NSA201006/Piezoelectric-Energy-Harvester/Report.pdf

# Electronics Workshop II, Project-2 Piezoelectric Energy Harvester Table 5, Nilgiri 104

Nagamalla Sai Abhinav
2024102037
Electronics and Communication Engineering IIIT Hyderabad
saiabhinav.nagamalla@students.iiit.ac.in

Praveen V
2024102019
Electronics and Communication Engineering IIIT Hyderabad
praveen.v@students.iiit.ac.in

Abstract—The project statement is to create a piezoelectric energy harvesting circuit with AC-DC conversion and voltage regulation to power a low-power sensor nodes from vibrations or footsteps. The piezoelectric energy harvesting technique is based on the materials property of generating an electric field when a mechanical force is applied. This phenomenon is known as the direct piezoelectric effect. AC-DC conversion is done by a full-wave rectifier while the voltage regulation is done with the help of a buck converter.

Index Terms—Piezoelectric materials, Buck converter, AC-DC regulator, Low Power devices.

I. INTRODUCTION

In recent decades, advancements in wireless technology and microelectronics have enabled the development of wearable devices, including clothing and accessories, powered by batteries or energy harvesting systems. Alongside this, the concept of the Internet of Things (IoT) has emerged, where wireless sensor networks are widely used. IoT has made it possible to deploy smart devices in remote or hard-to-reach locations, such as medical implants inside the human body and infrastructure within smart buildings, where recharging or replacing batteries is challenging.

Although low power integrated circuit technology has improved significantly, the energy density of conventional batteries still falls short of meeting the demands of these applications. As a result, there is a growing need for alternative energy harvesting methods to support self powered systems. Beyond being a practical and cost effective substitute for batteries, energy harvesting also contributes to reducing greenhouse gas emissions and promoting environmental sustainability.

Energy harvesting can be carried out by converting various forms of ambient energy available in the environment, as well as energy generated by humans in their daily activities.

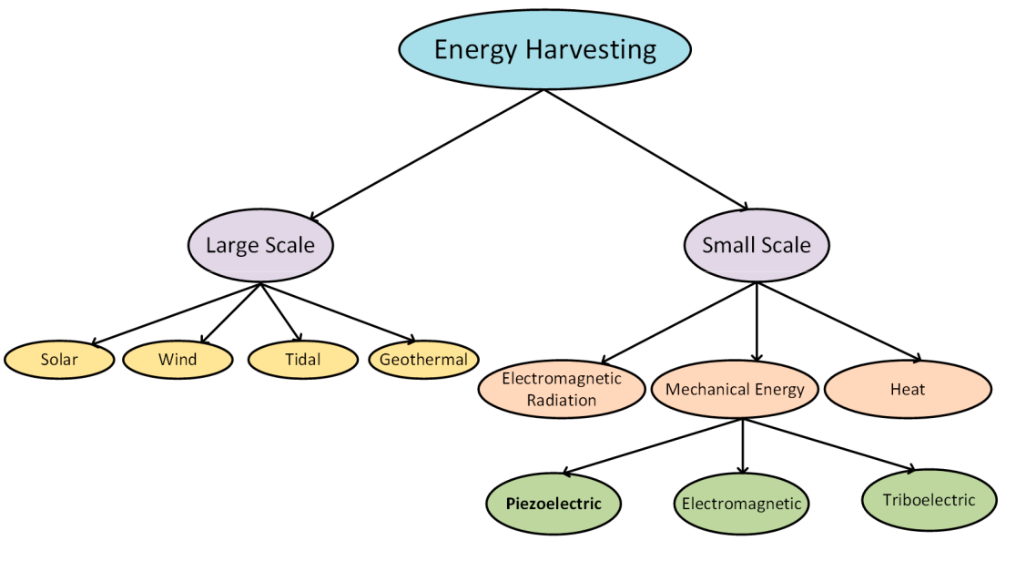
[picture p1: figure]

Fig. 1: Classification of energy harvesting sources

Human body mechanical energy and environmental mechanical energy are widely utilized due to their abundance in everyday life. Any motion in nature can serve as a potential source of kinetic energy. As a result, mechanical energy is one of the most commonly available forms of energy. By harvesting mechanical energy, sufficient power can be generated to support long-term operation of self-powered systems. For instance, approximately 10 mW can be harvested from upper limb movements, about 1 mW from typing activity, nearly 100 µW from breathing, and up to 1 W can be generated while walking.
We generate up to 1W. The harvested power density Pres for mechanical energy depends on the motion frequency and magnitude, as shown in the resonance power formula:

Pres = 4π

3mf ³
resyZmax | (1)

where m is the inertial mass, Zmax is the maximum displacement, fres is the resonance frequency, and y is the amplitude of vibration of the housing.

Fig. 2: Frequency level for different mechanical energy sources

II. PIEZO ARRAY

A. Piezoelectric Functionality

The piezoelectric sensor used in this project is typically made of lead zirconate titanate (PZT), which provides higher efficiency compared to natural materials like quartz.

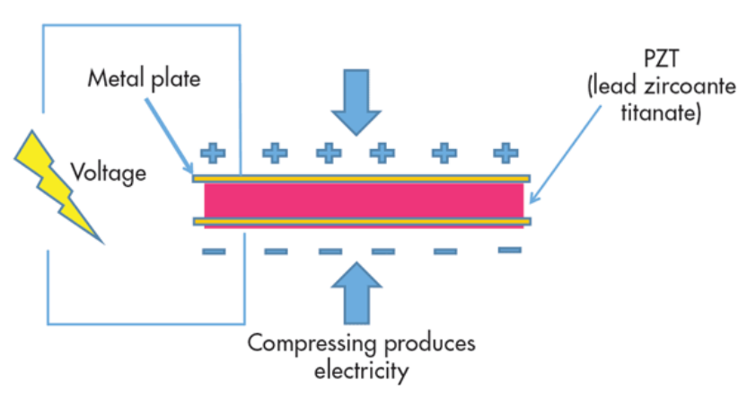
[picture p2: figure]

Fig. 3: Working of a piezoelectric sensor

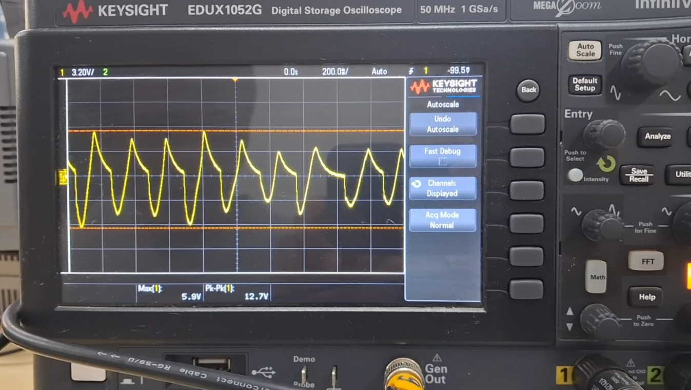
[picture p3: figure]

Fig. 4: Output obtained by tapping a single piezo

Piezoelectricity translates to “electricity from pressure.” The prefix piezo in Greek means to press or squeeze. Piezoelectric materials exhibit the piezoelectric effect. This allows a mechanical force to be applied to the material to deform it slightly and the material will produce an output electric power. This is done by rearranging the dipoles of the piezoelectric material. This rearrangement causes a change in the dipole density and therefore a change in the electric field between the dipoles. Because of this change in the electric field, the piezoelectric material produces an output electric power.

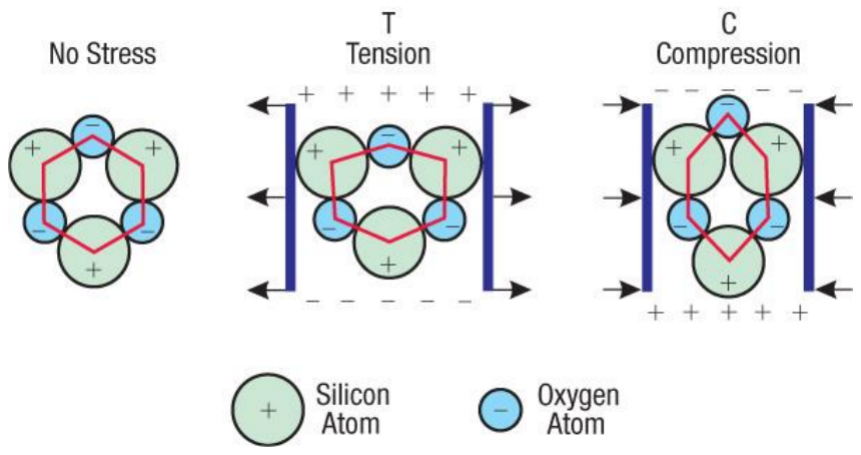
[picture p4: figure]

Fig. 5: The piezoelectric effect as observed in Quartz(SiO2)

B. Piezoelectric Sensor Array Configuration

In order to increase the output voltage and power, multiple piezoelectric sensors were connected in a combination of series and parallel configurations. A total of 20 piezoelectric sensors were used.
Four piezoelectric sensors were connected in series to form a single group. Connecting sensors in series increases the output voltage, as the voltages of individual sensors add up. Five such series groups were then connected in parallel. Parallel connection helps in increasing the output current while maintaining the voltage level.
Thus, the overall configuration consists of 5 parallel branches, each containing 4 piezoelectric sensors in series. This combination ensures that both voltage and current are improved, making the output more suitable for practical applications such as energy harvesting and powering low-power electronic circuits.
The output of a single piezoelectric sensor is typically very low and unstable. Hence, combining multiple sensors helps in improving the overall efficiency and usability of the generated electrical energy.

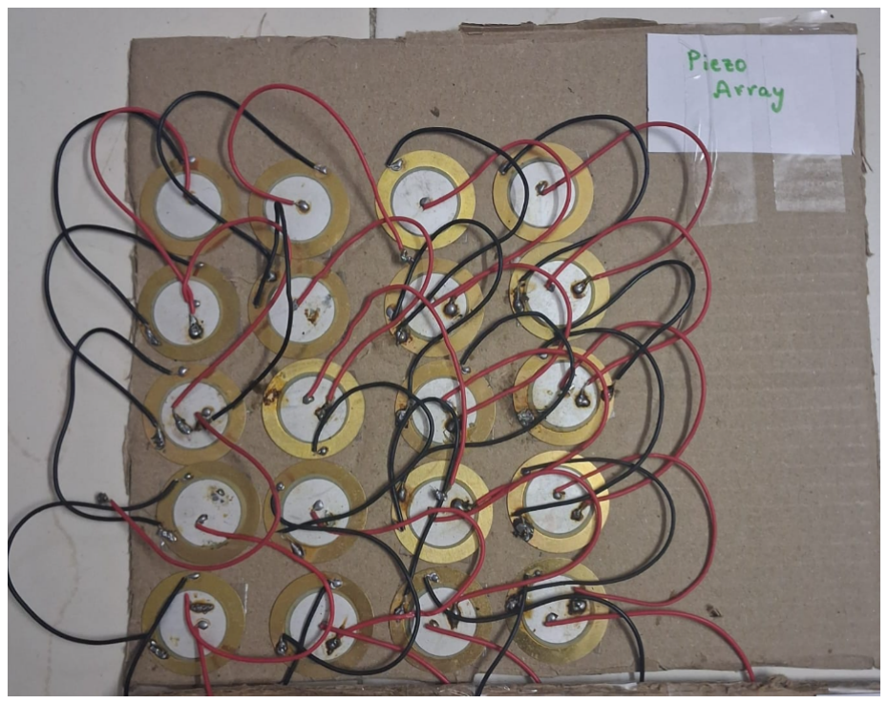
[picture p5: figure]

Fig. 6: Piezoelectric sensor setup

C. Demonstration videos

The working of the piezoelectric energy harvesting system is demonstrated through the video titled piezo output.mp4, which can be accessed here. (https://drive.google.com/drive/folders/1y0cQnUVNwf2e0C1tP7GsdZZJ_Ef59SJM?usp=drive_link)

III. AC-DC CONVERTER

A. Theory of AC-DC converter

The voltage generated by the piezoelectric array is inherently alternating (AC) in nature. To make it suitable for practical applications—especially for powering DC loads—we incorporate an AC–DC conversion stage. This is achieved through rectification using diodes, which allow current to flow only in one direction.
Instead of a half-wave rectifier, we employ a full-wave rectifier. Unlike the half-wave configuration—which utilizes only one half-cycle of the input signal—a full-wave rectifier converts both the positive and negative halves of the AC waveform into a unidirectional output. As a result, it delivers a higher average output voltage, improved power efficiency, and significantly reduced ripple. This makes it more suitable for energy harvesting applications like piezoelectric systems, where maximizing the usable output from a low and variable input is critical.
The resulting output is a pulsating DC signal, which can be further smoothed using filtering components such as capacitors if required.
If we need to rectify AC power to obtain the full use of both half-cycles of the sine wave, a full wave rectifier must be used.

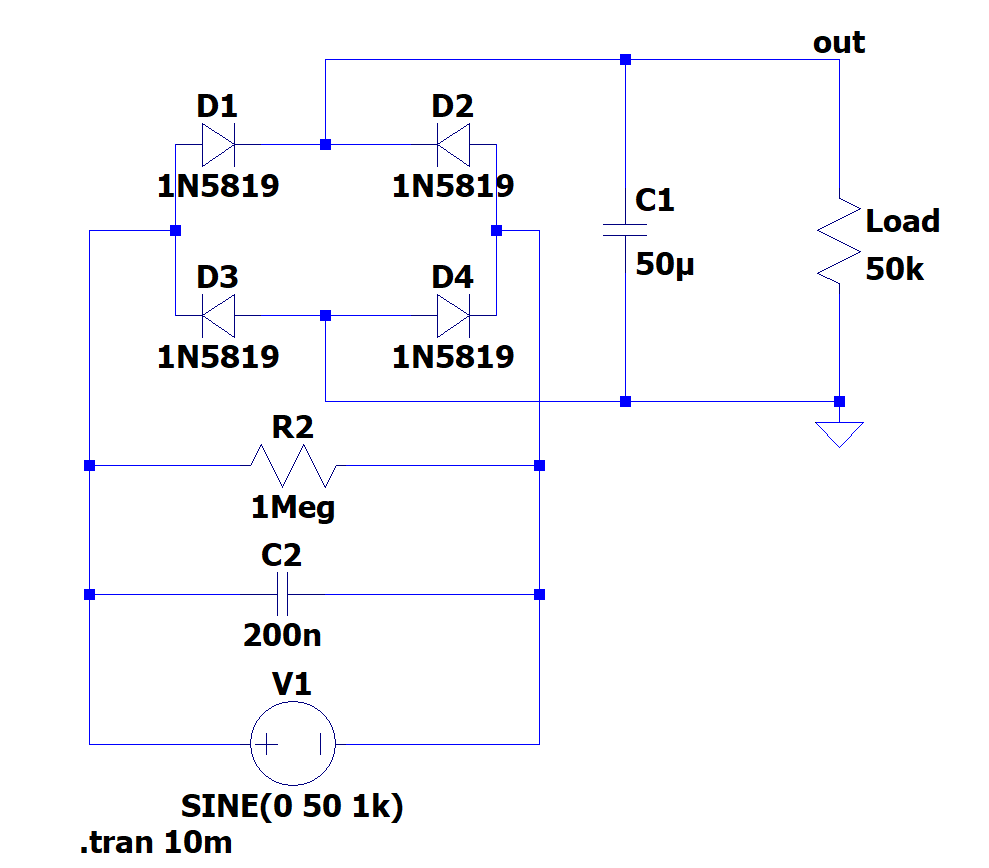
[picture p6: figure]

Fig. 7: LTSpice circuit of a full wave rectifier (Resistor and capacitor model the piezo array impedances)

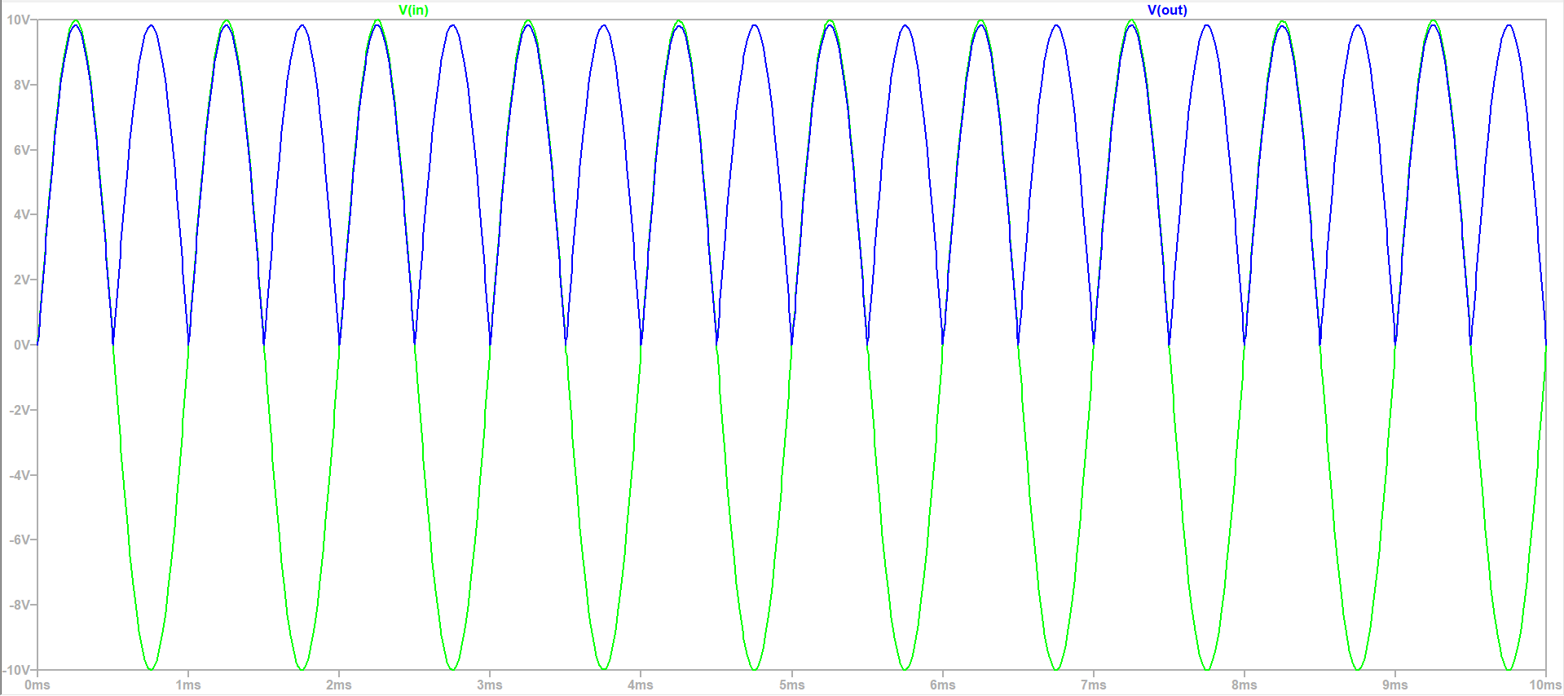
[picture p7: figure]

Fig. 8: LTspice simulation output for full-wave rectifier

The current flow is through two diodes in series for both polarities. Thus, two diode drops of the source voltage are lost (0.7 · 2 = 1.4 V for Si) in the diodes. This is a disadvantage which is dealt by using a schottky diode which has a much lower forward voltage drop of 0.2 V to 0.3 V. Therefore the voltage lost comes down to 0.4 V (0.2 · 2) to 0.6 V (0.3 · 2) which is significantly better than a normal silicon diode.

Current directions for the full-wave bridge rectifier circuit are as shown in the figure below for positive half-cycle and the figure below for negative half-cycles of the AC source waveform. Note that regardless of the polarity of the input, the current flows in the same direction through the load. That is, the negative half-cycle of source is a positive half-cycle at the load.

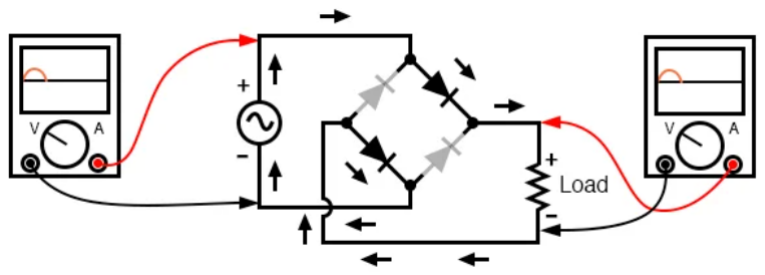
[picture p8: figure]

Fig. 9: Full-wave bridge rectifier: Current flow for positive half-cycles

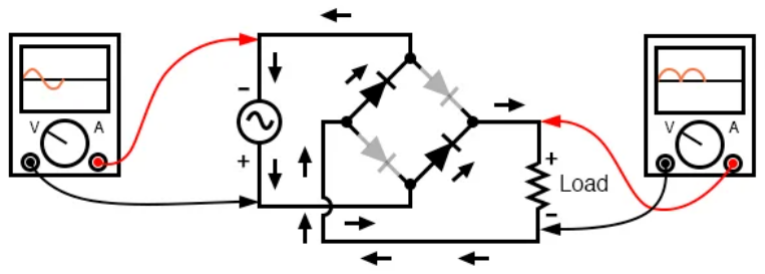
[picture p9: figure]

Fig. 10: Full-wave bridge rectifier: Current flow for negative half-cycles

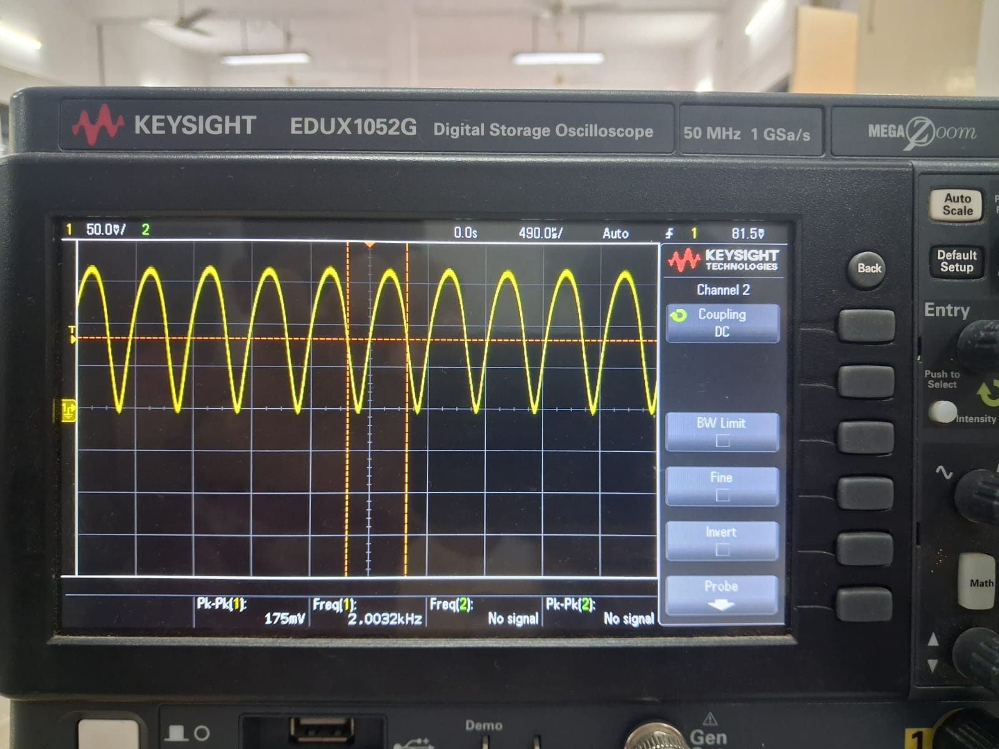
[picture p10: figure]

Fig. 11: Full Wave rectification of a sine wave

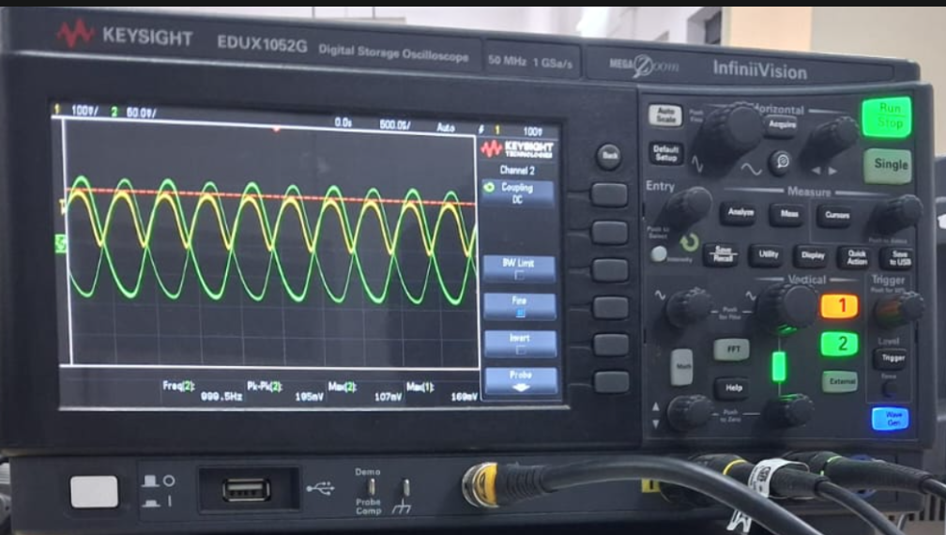
[picture p11: figure]

Fig. 12: Full Wave rectification plotted against input

A filter capacitor at the rectifier output smooths the pulsating DC by charging to the peak voltage and discharging slowly between cycles, effectively performing envelope detection to yield a steady DC level.

B. Obtained results

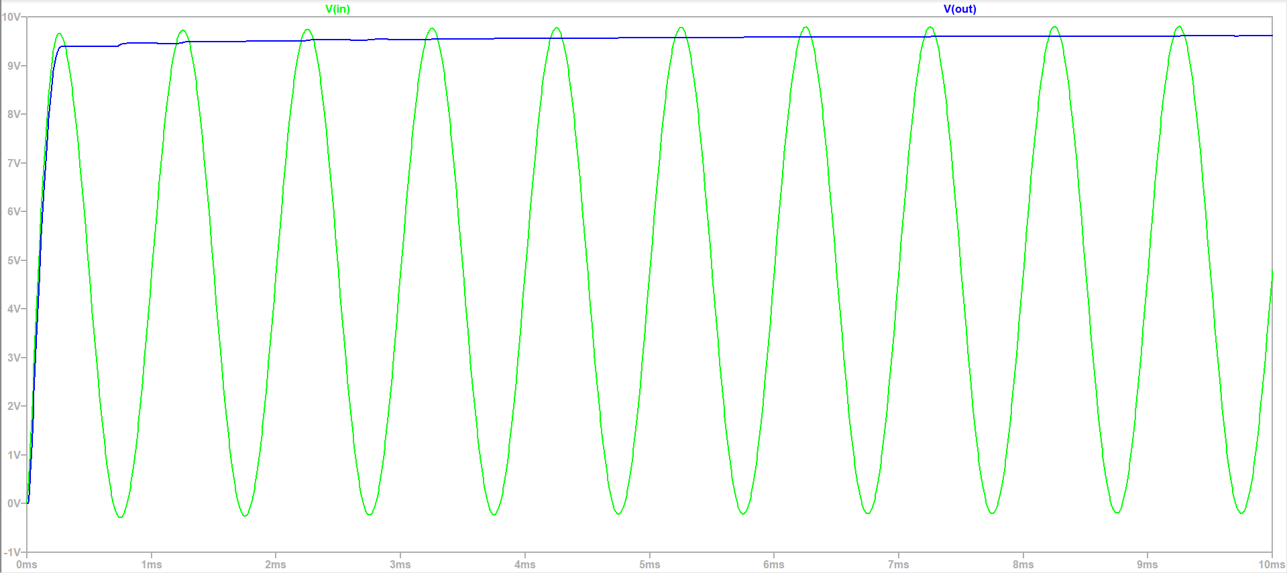
[picture p12: figure]

Fig. 13: Full-wave rectified output with filtering in LTspice

From the above simulation result, we can see for 10V AC Amplitude, output is around 9.6V DC. There is only 0.4V drop in the voltage due to 2 Schottky diodes used in series.

C. Demonstration videos

The working of the AC-DC converter is demonstrated through the videos titled piezo output after AC to DC.mp4 and piezo output of one series block after AC to DC.mp4, which can be accessed here. (https://drive.google.com/drive/folders/1y0cQnUVNwf2e0C1tP7GsdZZJ_Ef59SJM?usp=drive_link)

IV. BUFFER

In piezoelectric energy harvesting systems, the source typically exhibits a high output impedance and limited current capability. Directly connecting such a source to a load such as a buck converter will lead to significant loading effects. The switching action of the buck converter draws pulsed current, which can collapse the piezoelectric output voltage, reduce the effective harvested energy, and degrade overall system performance. Therefore, impedance matching is critical.

To address this issue, a buffer stage is introduced between the rectifier output and the buck converter. The buffer is implemented using an LM358 operational amplifier configured as a unity-gain voltage follower. In this configuration, the output is directly fed back to the inverting terminal, while the input is applied to the non-inverting terminal, ensuring that the output voltage closely follows the input voltage.

The key advantage of this configuration lies in its impedance characteristics. The op-amp presents a very high input impedance to the piezoelectric source, thereby minimizing the loading effect and allowing maximum voltage to be extracted. At the same time, it provides a low output impedance to drive the buck converter effectively, ensuring stable operation even under dynamic load conditions. Thus, the buffer stage acts as an isolation interface between the high-impedance energy source and the low-impedance switching load.

The LM358 buffer is powered directly from the piezo rectifier output, not from any external supply. Since the LM358 supports single-supply operation down to approximately 3 V, and the rectified output typically reaches 5–10 V during mechanical excitation, the op-amp is able to self-power from the harvested energy itself. This ensures that the buffer stage remains fully consistent with the self-powered design objective of the system. The LM358 buffer working range of voltage is 3 to 32 V which falls in piezo rectifier output voltage range.

Overall, the buffer stage significantly improves energy transfer efficiency and system stability by decoupling the piezo rectifier stage and the buck controller stage

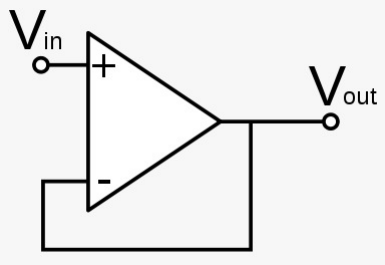
[picture p13: figure]

Fig. 14: Circuit Diagram of the Buffer used

V. BUCK CONVERTER

The voltage obtained after rectification is a varying DC voltage. A DC–DC buck converter steps this down to the required constant 3.3 V output using a high-frequency switching power MOSFET (IRLZ44N) controlled by a PWM signal from an Arduino microcontroller.

A. Why Not a Linear Voltage Regulator?

A linear voltage regulator such as the LM7805 could theoretically step down the rectified voltage to a fixed output, but it is highly unsuitable for this application for the following reasons.
- Output voltage regulated by adjusting the transistor base current
- Power absorbed by the load Po = VoIo
- Power dissipated by the transistor PT = VCEIo
- Inefficient due to high power dissipation by the transistor.
- Requires a minimum headroom voltage Vheadroom = Vin− Vout to maintain regulation; for our design Vheadroom = 10 − 3.3 = 6.7 V, meaning the transistor must withstand and waste an enormous voltage drop, making it completely impractical
To tackle this problem, we model the buck converter as a switching voltage regulator, as explained below.
B. Theory of switching voltage regulator

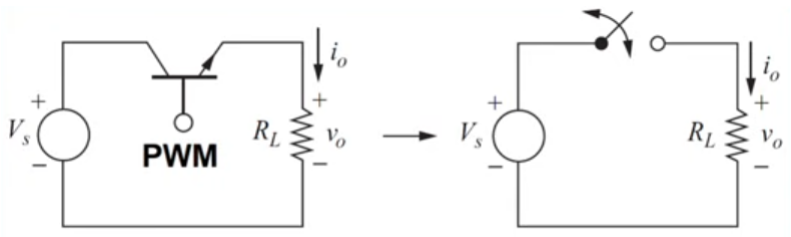
[picture p14: figure]

Fig. 15: Buck converter modelled as a switching voltage regulator

The buck converter consists of an N-MOSFET switch, inductor L, capacitor C, freewheeling diode D1, and load R. The PWM duty cycle is defined as:

D =

ton
T

=

ton
ton + toff

(2)

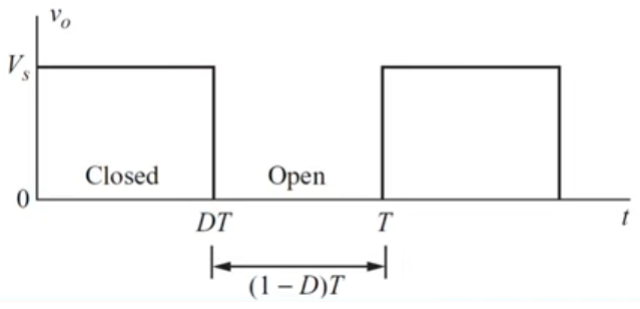
[picture p15: figure]

Fig. 16: Duty cycle of a switching voltage regulator

- Gate voltage = 0: switch open ⇒ Vout = 0
- Gate voltage = high: switch closed ⇒ Vout = Vin
- Switch closed: diode D1 is reverse biased
- Switch open: diode D1 forward biased; inductor current freewheels through D1
C. Derivations and Calculations for Buck converter

It is important to note that the buck converter is designed for a fixed input of Vin = 10 V, representing the nominal rectified output under steady mechanical excitation. Under this assumption, a fixed duty cycle of D = 0.33 is sufficient to regulate the output to 3.3 V. However, in practice, the piezoelectric source is inherently variable the rectified voltage fluctuates depending on the amplitude and frequency of mechanical input. To account for this, a feedback based bang-bang controller (discussed in next Section) is introduced, which dynamically adjusts the duty cycle in real time to maintain a stable 3.3 V output across varying input conditions. Output Voltage: The average output voltage is obtained by integrating over one switching period:

Vout =

1
T

Z T

0

Vout(t) dt

=

1
T

"Z DT

0

Vin dt +

Z T

DT

0 dt#

=

Vin · DT
T

(3)

Vout = D · Vin | (4)

The required duty cycle is therefore:

D =

Vout
Vin

=

3.3
10
= 0.33 | (5)

Steady-State Inductor Ripple: Since the gate signal is periodic, iL(t + T) = iL(t). Volt-second balance requires the average inductor voltage to be zero:

VL,avg =

1
T

Z t+T

t

VL(τ ) dτ = 0 | (6)

Switch closed (0 ≤ t ≤ DT):

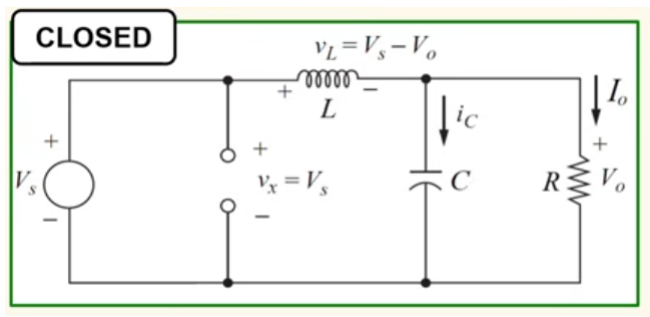
[picture p16: figure]

Fig. 17: Buck converter circuit during switch ON (closed) condition

VL = VS − Vo = L

diL
dt | (7)

∆iL,closed =

(VS − Vo) DT
L

(8)

Switch open (DT ≤ t ≤ T):

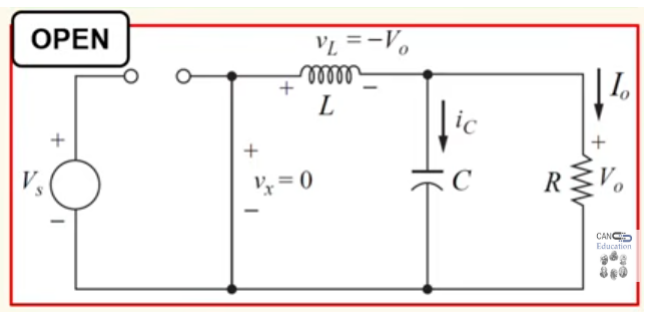
[picture p17: figure]

Fig. 18: Buck converter circuit during switch OFF (open) condition

VL = −Vo = L

diL
dt | (9)

∆iL,open =

−Vo (1 − D) T
L

(10)

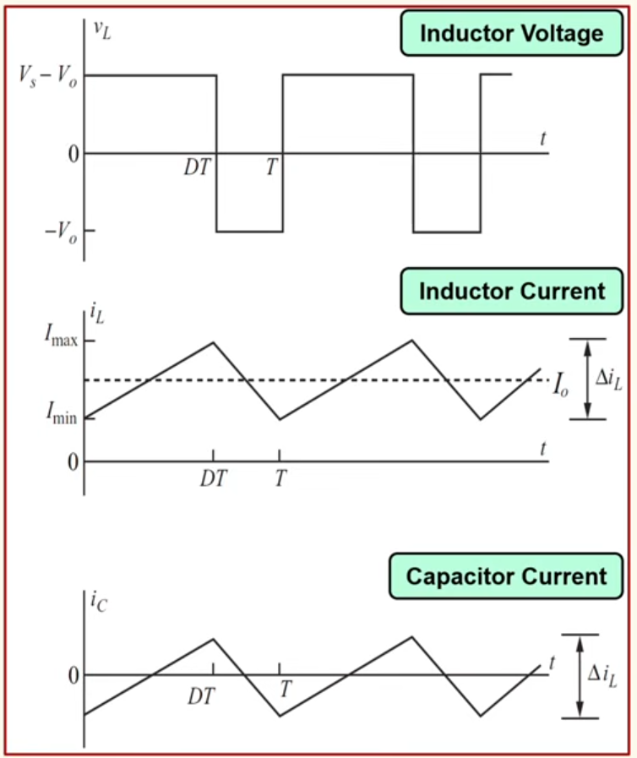
[picture p18: figure]

Fig. 19: Buck converter waveforms

Applying the steady-state condition ∆iL,closed + ∆iL,open = 0 confirms Vo = DVS. The peak-to-peak inductor current ripple is:

∆iL =

Vo(1 − D)
L fs

(11)

Inductor Design: At steady state IL = Io = Vo/R, giving peak and minimum currents:

Imax =

Vo
R

+

Vo(1 − D)
2Lfs

(12)

Imin =

Vo
R

−

Vo(1 − D)
2Lfs

(13)

For Continuous Conduction Mode (CCM), Imin > 0, which gives:

Lmin =

(1 − D) R
2 fs

(14)

Taking ∆iL = 5% of Io = 1 A = 50mA and fs = 50 kHz:

L =

Vo(1 − D)
∆iL · fs

=

3.3 × 0.67
0.05 × 50 × 10³

≈ 884.4 µH (15)

We select L = 890 µH (four 220 µH + one 10 µH inductors in series). The revised ripple becomes:

∆iL,new =

Vo(1 − D)
L fs

=

3.3 × 0.67
890 × 10⁻⁶ × 50 × 10³

≈ 49.6 mA

(16)

The Arduino can provide PWM at up to 62.5 kHz, so fs = 50 kHz is well within range. The inductor RMS current is:

IL(rms) =

s
I

2
L +
∆iL/2
√
3

2
≈ 2.0001 A (17)

Capacitor Design: The charge variation equals the area under the iC vs. t graph:

∆Q =

∆iL
8 fs

(18)

Output Voltage Ripple

Capacitor current: iC = iL − io | (19)
Capacitor charge: Q = CVo | (20)

Change in capacitor charge:

∆Q = C∆Vo | (21)

∆Q =

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
∆iL T
8

=

∆iL
8fs

(22)

Change in output voltage:

∆Vo =

∆Q
C

=

∆iL
8Cfs

(23)

∆iL =

Vo(1 − D)
Lfs

(24)

∆Vo =

1
8Cfs

·

Vo(1 − D)
Lfs

(25)

=

Vo(1 − D)
8LCf ²
s

(26)

Rearranging with ∆Vo/Vo = 1% (target):

C =

1 − D

8L

∆Vo
Vo
f

2
s
≈ 3.76 µF | (27)

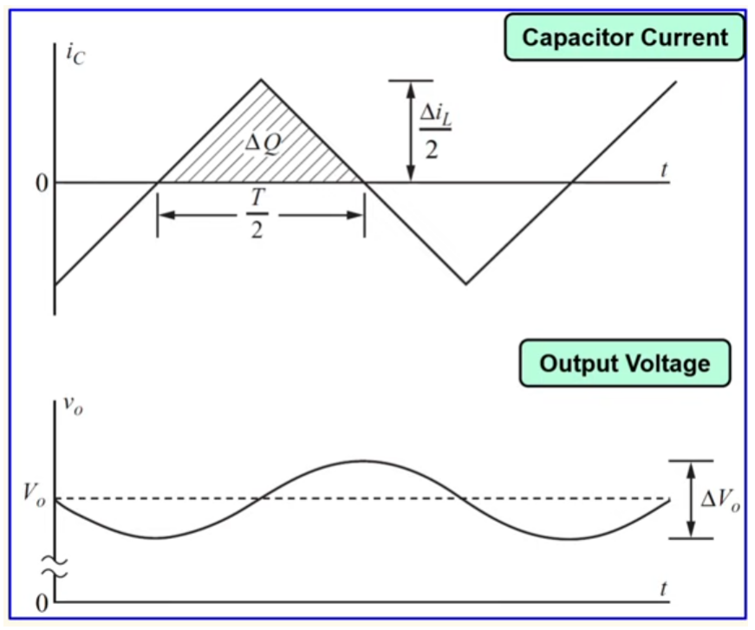
[picture p19: figure]

Fig. 20: Output voltage ripple

Capacitor ESR: The maximum allowable equivalent series resistance rC is:

∆Vo = rC · ∆iC = rC · ∆iL | (28)

rC =

∆Vo
∆iL

=

0.033
0.05
≈ 0.06 Ω | (29)

The capacitor RMS current is:

IC(rms) =

s
I

2
C,dc +
∆iL/2
√
3

2
≈ 0.02 A (30)

TABLE I: Buck Converter Design Values

Parameter | Calculated | Selected
Duty cycle D | 0.33 | 0.33
fs | 50 kHz | 50 kHz
L | 884 µH (minimum) | 890 µH
C | 3.76 µF (minimum) | 5 µF
ESR rC | 14.3 Ω | —
D. LTSpice Plots

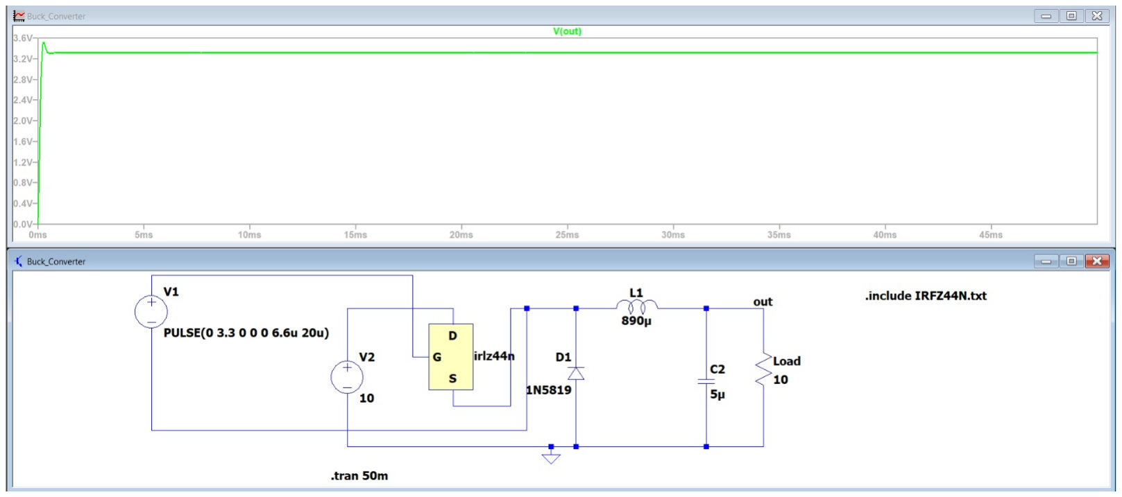
[picture p20: figure]

Fig. 21: LTspice circuit diagram and Output Plot

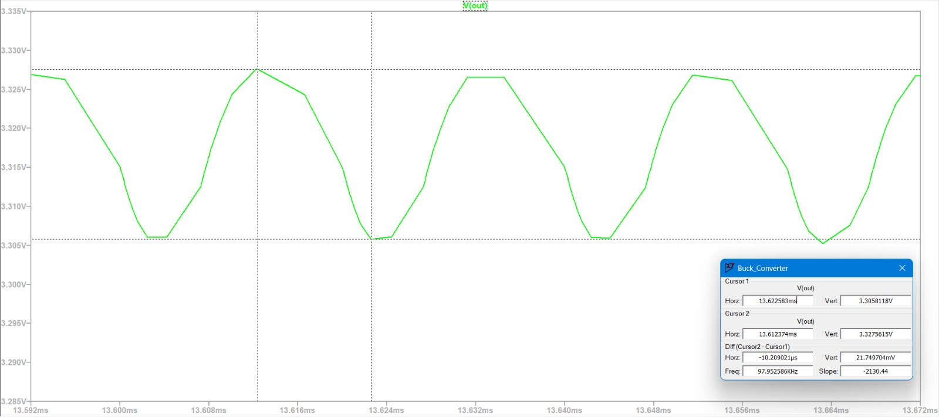
[picture p21: figure]

Fig. 22: Output Voltage Ripple

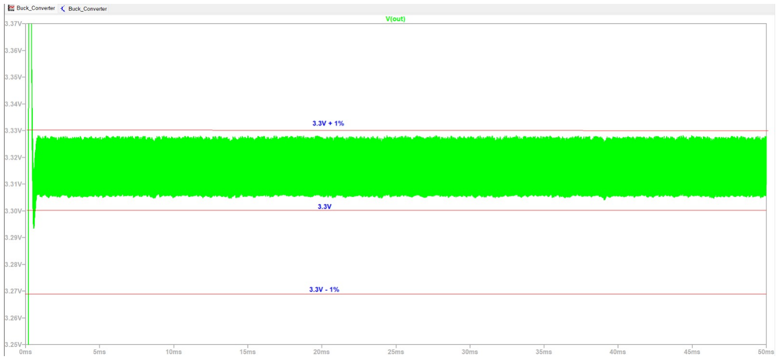
[picture p22: figure]

Fig. 23: Plot depicting less than 1% error in Vout

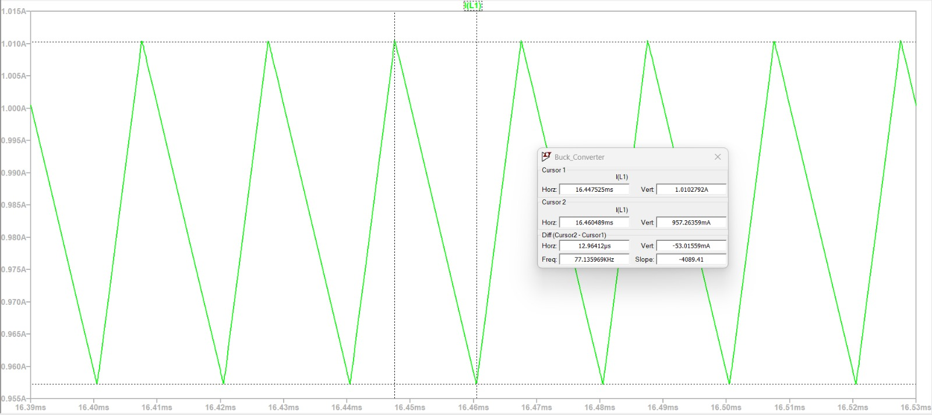
[picture p23: figure]

Fig. 24: Inductor Current ripple

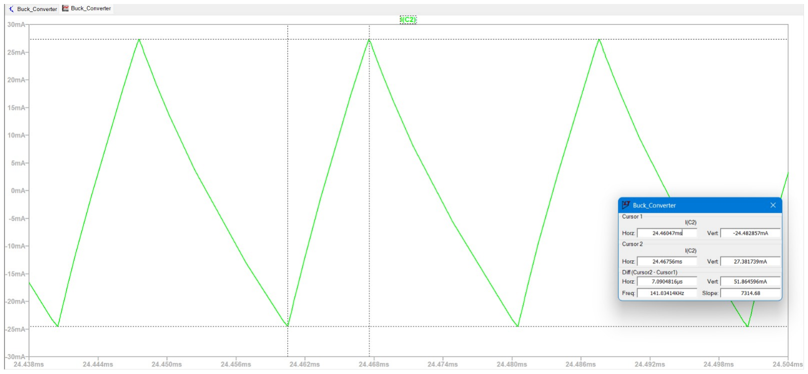
[picture p24: figure]

Fig. 25: Capacitor Current ripple

E. Theoretical vs simulation vs hardware
LTspice simulation confirms ∆Vo ≈ 22 mV < 33 mV (target) and ∆iL ≈ 53 mA ≈ 50 mA (target), verifying the design meets all the targeted specifications.

TABLE II: Comparison of Theoretical, Simulation, and Hardware Results

Parameter | Theoretical | Simulation | Hardware
Output Current ripple(mA) Output Voltage ripple(mV) | 50 30 | 53 22 | – –
F. Demonstration videos
The | working | of | the | Buck | converter
is | demonstrated | through | the | videos | titled
buck working with no controller for 20V.mp4, | which
can be accessed here. (https://drive.google.com/drive/folders/1y0cQnUVNwf2e0C1tP7GsdZZJ_Ef59SJM?usp=drive_link)

VI. BUCK CONTROLLER

To regulate the variable DC output obtained from the piezoelectric energy harvesting stage, a buck converter is employed to step down the voltage to a stable 3.3 V. The input to the converter can vary over a wide range (approximately 0–10 V) depending on the mechanical excitation of the piezoelectric source. So, the duty cycle of the PWM needs to be varied accordingly based on this input DC voltage. To drive this PWM duty cycle, a feedback based controller is made using Arduino.
Since the Arduino analog input pins are limited to reading a maximum of 5 V, a resistive voltage divider (6.8 kΩ and 10 kΩ) is used to scale the output voltage to a safe measurable range. This gives a safe measurable output range of 0 to 8.4 V, which is more than sufficient for the target output of 3.3 V. The scaled voltage is sampled using the ADC and then converted back to the actual output voltage using an appropriate scaling factor. The voltage divider is implemented using a 6.8 kΩ resistor (R1) in series with a 10 kΩ resistor (R2), with the ADC input connected across R2. The division ratio is given by:

VADC = Vout ×

R2
R1 + R2

= Vout ×

10
6.8 + 10

= Vout × 0.595

(31)
The Arduino ADC resolves this scaled voltage over 1023 steps with a 5 V reference, yielding a step size of approximately 4.89 mV per count. The actual output voltage is recovered in firmware by applying the inverse of the divider ratio:

Vout =

ADCraw
1023

× 5.0 ×

1
0.595

(32)

To further improve measurement accuracy, 16 consecutive ADC samples are averaged before applying the scaling factor, effectively suppressing high-frequency noise on the feedback line.
The control strategy employed is a discrete-time hysteretic (bang–bang) feedback controller with incremental duty-cycle adjustment. Unlike classical proportional (P), proportionalderivative (PD), or proportional-integral-derivative (PID) controllers, this approach does not compute a continuous error signal or its derivatives. Instead, it operates based on threshold comparison. It is a simple, two-state (on/off) strategy ideal for high-speed, low-accuracy applications.
Intuitively, the controller behaves like a simple decision system: it continuously checks whether the output voltage is too high, too low, or within an acceptable range. If the voltage is higher than the desired value, the controller reduces the duty cycle of the PWM signal, thereby lowering the output. If the voltage is lower than the desired value, the duty cycle is increased to raise the output. When the voltage lies within a small tolerance band around the target value, no adjustment is made. This creates a stable operating region and avoids unnecessary switching.
Mathematically, the control action can be described as:

if Vout > Vtarget + ∆, duty ↓

if Vout < Vtarget − ∆, duty ↑

otherwise, duty remains unchanged

where Vtarget = 3.3 V and ∆ = 0.03 V.
Additionally, a minimum voltage threshold of 1 V is imposed. If the sensed voltage falls below this level, the controller reduces the duty cycle to a low value, preventing operation under insufficient input power conditions.
The PWM signal controlling the buck converter is generated using Timer1 of the Arduino in fast PWM mode. The duty cycle is updated in discrete steps, enabling real-time feedback control with minimal computational complexity.
This hysteretic control approach is particularly well-suited for piezoelectric energy harvesting systems, where the input is inherently variable. Its simplicity, robustness, and low computational overhead make it an effective solution for maintaining a stable output voltage without the need for complex tuning required in PID-based controllers.
The regulated DC output is maintained at approximately 3.3V with a maximum deviation of ±1%, demonstrating satisfactory performance under the given operating conditions.
A. Use of Arduino for Control Implementation

It is important to clarify that the use of the Arduino in this project is primarily for prototyping, validation, and demonstration purposes, rather than as a final deployment solution. While the Arduino requires an external power supply and has non-negligible power consumption, its inclusion allows rapid implementation and testing of the control strategy.

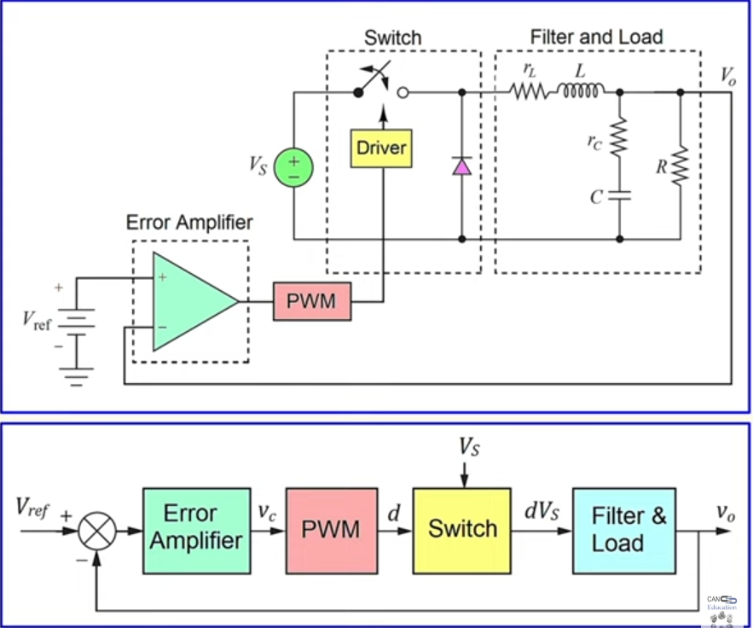
[picture p25: figure]

Fig. 26: Block Diagram of a practical Controller Circuit

The objective of this work is to validate the feasibility of regulating a highly variable piezoelectric output using a feedback-controlled buck converter. The Arduino serves as a flexible platform to implement, modify, and observe the behavior of the control algorithm in real time, thereby enabling efficient verification of the design approach.
In practical energy harvesting systems, dedicated buck converter and controller ICs are typically used instead of microcontrollers. These ICs are specifically designed for low-power operation and do not require a continuous external supply. They are capable of cold-start operation, wherein the initial energy harvested from the piezoelectric source is sufficient to power the control circuitry, after which the system sustains itself through the feedback loop.

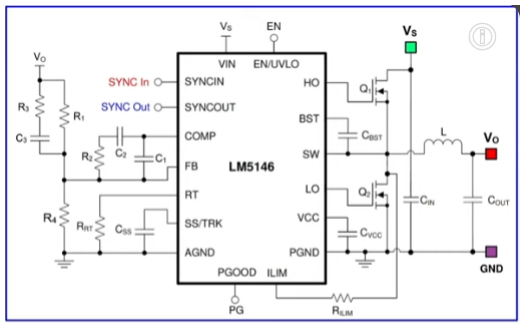
[picture p26: figure]

Fig. 27: LM5146 IC Circuit Diagram

Such ICs (like LM5146) incorporate internal control mechanisms, including ramp generators and compensation networks, to regulate the output voltage efficiently. Depending on the design requirements, higher-order control strategies (such as proportional or PID-based compensation) can be implemented using external components integrated with the IC.

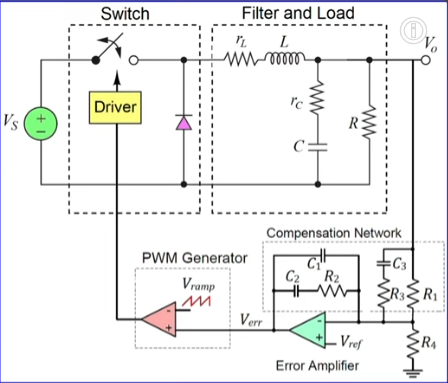
[picture p27: figure]

Fig. 28: Example of an higher order controller design

Commercially | available | evaluation | boards, | while
performance-optimized, are cost-prohibitive (5,000–10,000 rupees). A custom PCB with a dedicated controller IC would offer a compact, cost-effective alternative, but PCB design and fabrication were beyond the scope of this project. Therefore, the Arduino-based implementation should be viewed as a proof-of-concept platform that demonstrates the validity of the control strategy. The insights gained from this implementation can be directly translated into a low-power, fully integrated hardware solution for real-world piezoelectric energy harvesting applications.
B. Theoretical vs Hardware
Finally, the theoretical analysis predicts that the output voltage settles at 3.3 V. In simulation, the voltage stabilizes at approximately 3.32 V, as demonstrated in the video below which is within the targeted ±1% threshold.
C. Demonstration videos
The working of the Buck Converter with Controller is demonstrated through the videos titled buck working.mp4 and buck working with piezo.mp4 which can be accessed here. (https://drive.google.com/drive/folders/1y0cQnUVNwf2e0C1tP7GsdZZJ_Ef59SJM?usp=drive_link)

VII. COMPARATOR

A. Op-Amp based comparators
The op-amp comparator is a fundamental analog circuit used to compare two voltage levels. It compares an input voltage with a reference voltage, VREF, and produces a binary output based on the result of this comparison.
In its simplest form, the comparator operates in open-loop configuration, without any feedback. Due to the very high open-loop gain of the op-amp, even a small difference between the input terminals drives the output into saturation. If the voltage at the non-inverting terminal (V+) is greater than the voltage at the inverting terminal (V−), the output saturates to the positive supply rail. Conversely, if V+ < V−, the output saturates to the ground rail. Mathematically, this can be expressed as:

Vout =

(
+VCC, if V+ > V−
0, | if V+ < V−

Depending on how the input and reference voltages are applied, two configurations are commonly used. In a non-inverting comparator, the input signal is applied to the non-inverting terminal and the reference voltage is applied to the inverting terminal, resulting in a high output when the input exceeds the reference. In contrast, in an inverting comparator, the input signal is applied to the inverting terminal and the reference voltage to the non-inverting terminal, producing a high output when the input falls below the reference.
Thus, an op-amp comparator effectively converts an analog input signal into a digital output, making it a key building block in threshold detection and window comparator circuits.

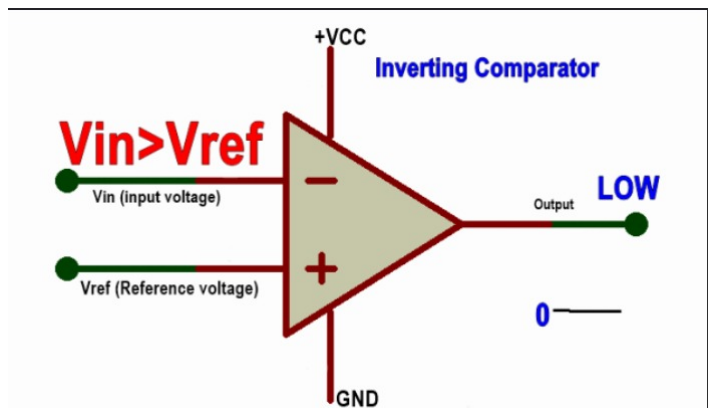
[picture p28: figure]

(a) | Inverting | Configuration

Vin > Vref

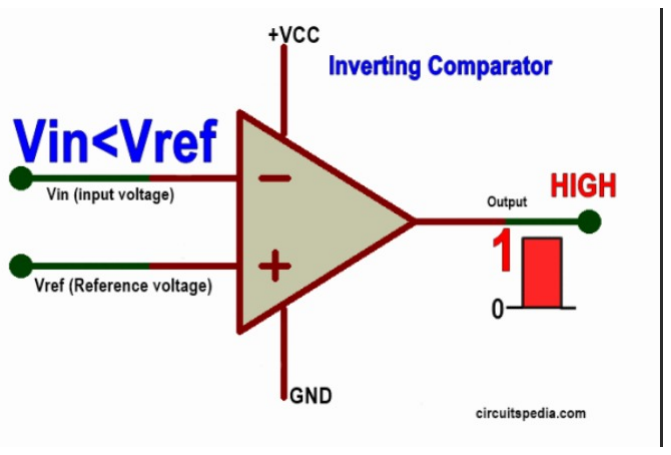
[picture p29: figure]

(b) | Inverting | Configuration

Vin < Vref

(c) Non-Inverting Configuration Vin < Vref
(d) Non-Inverting Configuration Vin > Vref

Fig. 29: Op-Amp Comparator topologies

B. Window comparator

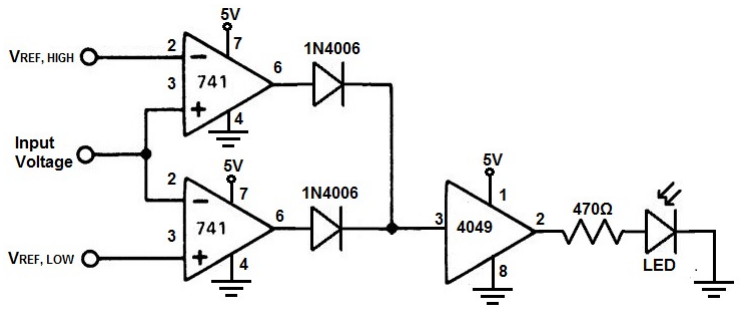
[picture p30: figure]

Fig. 30: Window comparator circuit diagram

A window comparator is used to determine whether an input voltage lies within a specified range, defined by an upper and a lower reference level. It is implemented by combining two op-amp comparators—one configured as a non-inverting comparator and the other as an inverting comparator.

In this design, the desired operating voltage is centered around 3.3 V, with acceptable limits set between 3.1 V and 3.5 V. The upper threshold (3.5 V) is monitored using a non-inverting comparator. In this configuration, the input voltage is applied to the non-inverting terminal, while the reference voltage (3.5 V) is applied to the inverting terminal. As a result, the comparator output goes high when the input voltage exceeds 3.5 V, effectively detecting an over-voltage condition.

Similarly, the lower threshold (3.1 V) is monitored using an inverting comparator. Here, the input voltage is applied to the inverting terminal, and the reference voltage (3.1 V) is applied to the non-inverting terminal. This configuration ensures that the output goes high when the input voltage drops below 3.1 V, indicating an under-voltage condition.

The outputs of these two comparators are combined using a diode-based OR configuration, in which each comparator output is connected through a diode to a common node. This arrangement ensures that if either comparator indicates a threshold violation, the corresponding diode conducts and pulls the combined output high. Thus, a high output is produced whenever the input voltage falls outside the defined window (i.e., either above 3.5 V or below 3.1 V), representing a “danger” condition.

To make the system more intuitive, a NOT gate is added at the final stage to invert the logic, so that the output is high only when the input voltage lies within the safe operating range (between 3.1 V and 3.5 V).

The outputs are visually indicated using LEDs: a red LED turns ON when the voltage falls outside the permissible window (danger condition), while a blue LED turns ON when the voltage lies within the safe range of 3.1 V to 3.5 V.

TABLE III: Window Comparator Truth Table

Condition on Vin | Danger | Safe | LED Indication
Vin < 3.1 V | 1 | 0 | Red ON, Blue OFF
3.1 V ≤ Vin ≤ 3.5 V | 0 | 1 | Red OFF, Blue ON
Vin > 3.5 V | 1 | 0 | Red ON, Blue OFF

In LTspice, only the window comparator stage was simulated to verify the threshold detection behavior. The final hardware implementation includes an additional inverter stage for logic inversion and LED indication of the safe and danger conditions.

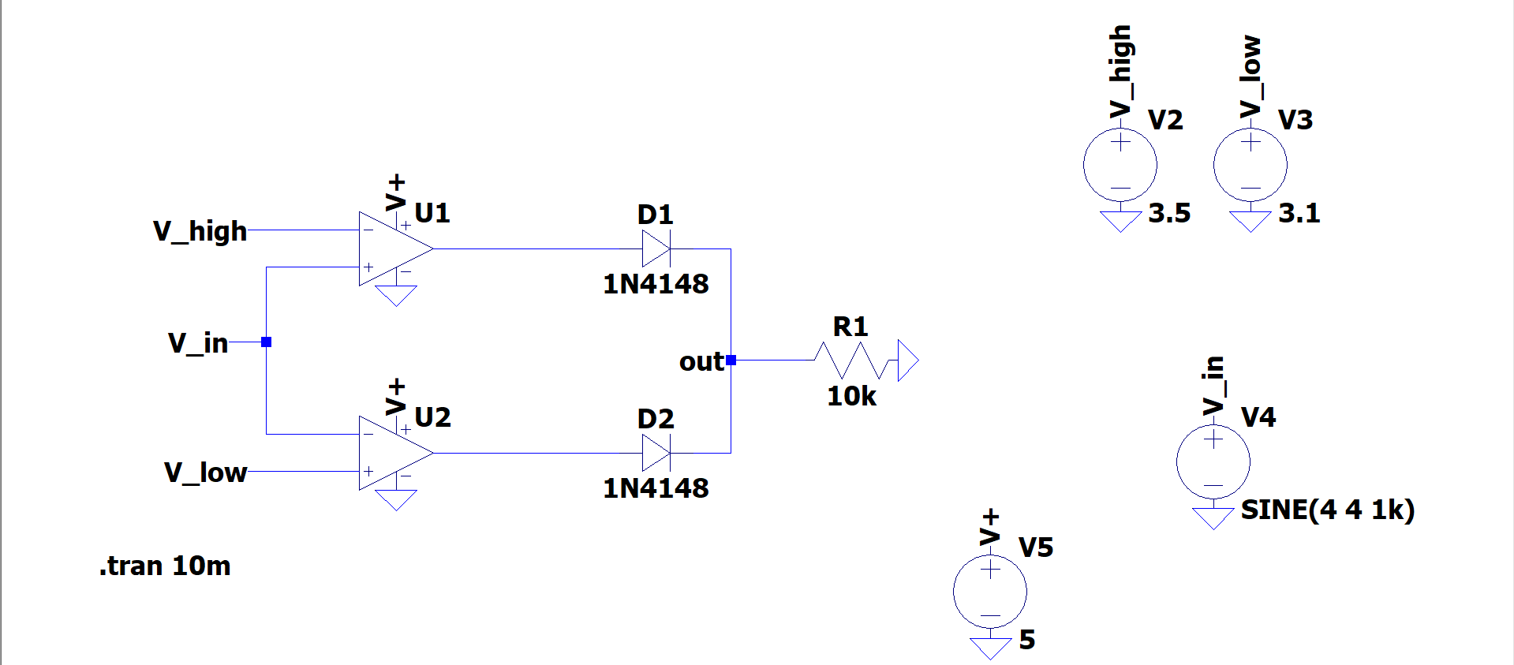
[picture p31: figure]

Fig. 31: LtSpice circuit for window comparator

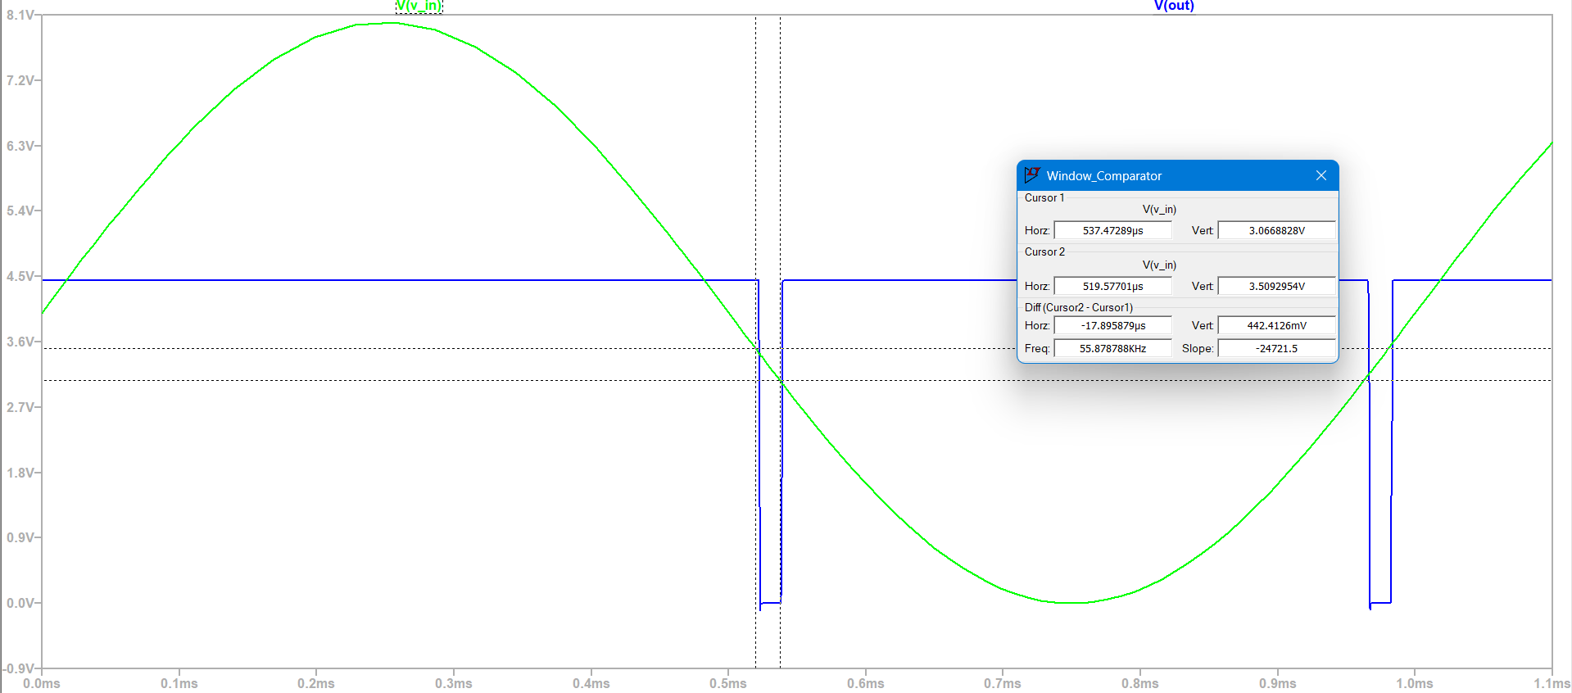
[picture p32: figure]

Fig. 32: LTspice simulations of the Window Comparator

We can see from the above plot that the output goes to low in the region of 3.1 V to 3.5 V. This is the immediate output of the window comparator indicating the ”danger” region.

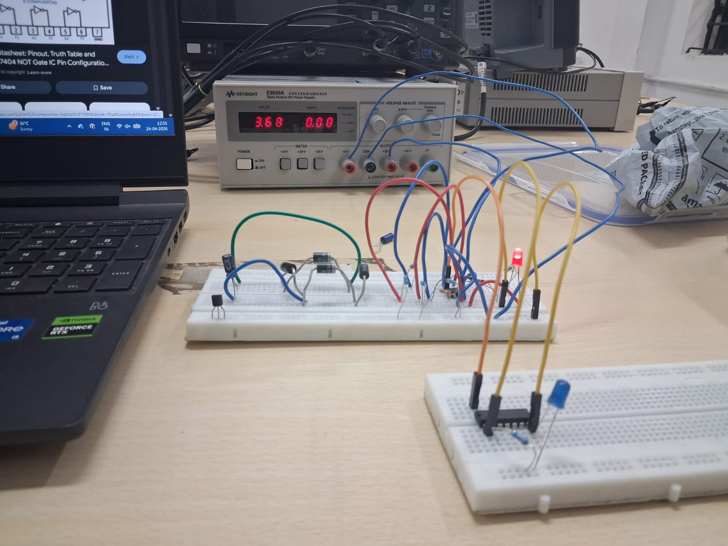
[picture p33: figure]
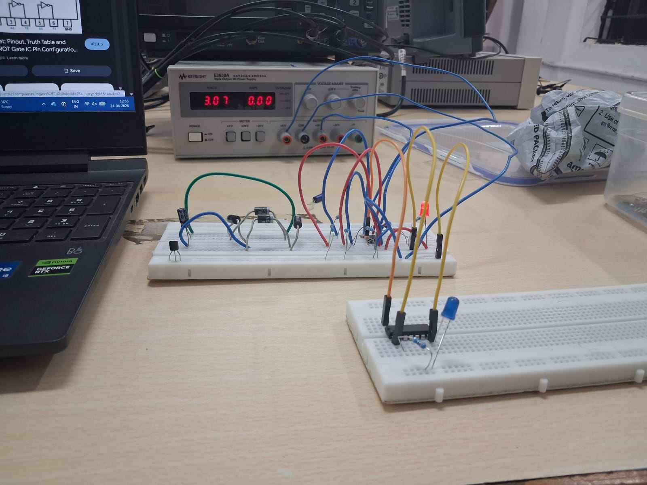
[picture p34: figure]

(a) Vin just above 3.5 V | (b) Vin just below 3.1 V

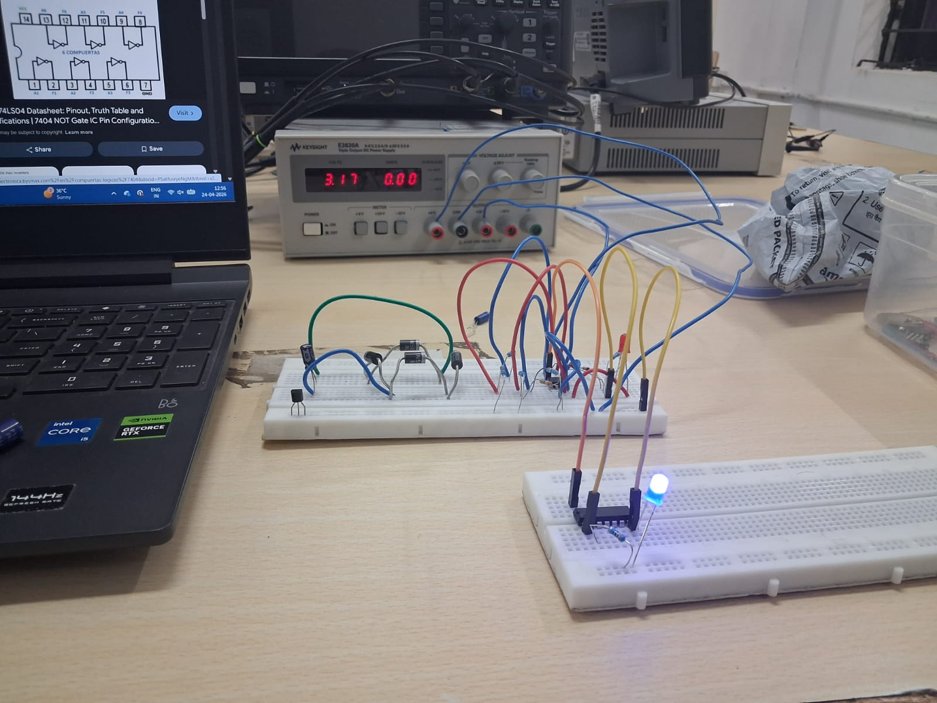
[picture p35: figure]
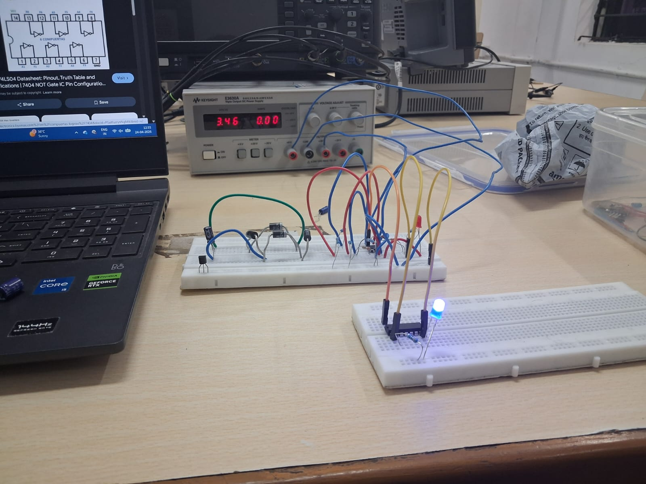
[picture p36: figure]

(c) Vin just above 3.1 V | (d) Vin just below 3.5 V

Fig. 33: Hardware Window Comparator Output at Edge cases

The hardware and simulation results match as shown above. In the hardware implementation, the reference voltages of 3.1 V and 3.5 V are generated using a resistor divider network derived from a regulated 5 V supply provided by the Arduino. This supply is used only for establishing stable reference thresholds for the window comparator.

The reference voltages are derived using resistive voltage dividers from the Arduino’s regulated 5 V output. For a voltage divider with output Vref = VCC ·

R2
R1 + R2

, the resistor values
are selected from the standard E24 series as follows:
- Lower threshold (3.1 V): R1 = 20 kΩ, R2 = 33 kΩ

Vlow = 5 ×

33
20 + 33

≈ 3.11 V

- Upper threshold (3.5 V): R1 = 15 kΩ, R2 = 36 kΩ

Vhigh = 5 ×

36
15 + 36

≈ 3.53 V

Both pairs use standard resistor values and achieve the target thresholds within ±1%, well within the tolerance of the window comparator’s operating range.
It is important to note that the piezoelectric system in this project is intended for energy harvesting, where the generated voltage is inherently variable and dependent on mechanical excitation. In practical applications, piezoelectric sources are typically used to supplement existing power systems rather than operate as completely standalone replacements. Therefore, the use of a stable external reference for threshold detection does not contradict the fundamental objective of the system.
Furthermore, the resistor divider network draws negligible current (on the order of nW as verified through LTspice simulations), resulting in near-zero power consumption. As such, the reference generation stage does not impose any significant load on the system and serves purely as a low-power sensing mechanism for safe voltage operation. Hence, the use of an external reference voltage is justified as it ensures reliable and accurate window detection while maintaining the overall efficiency and intent of the piezoelectric energy harvesting system.

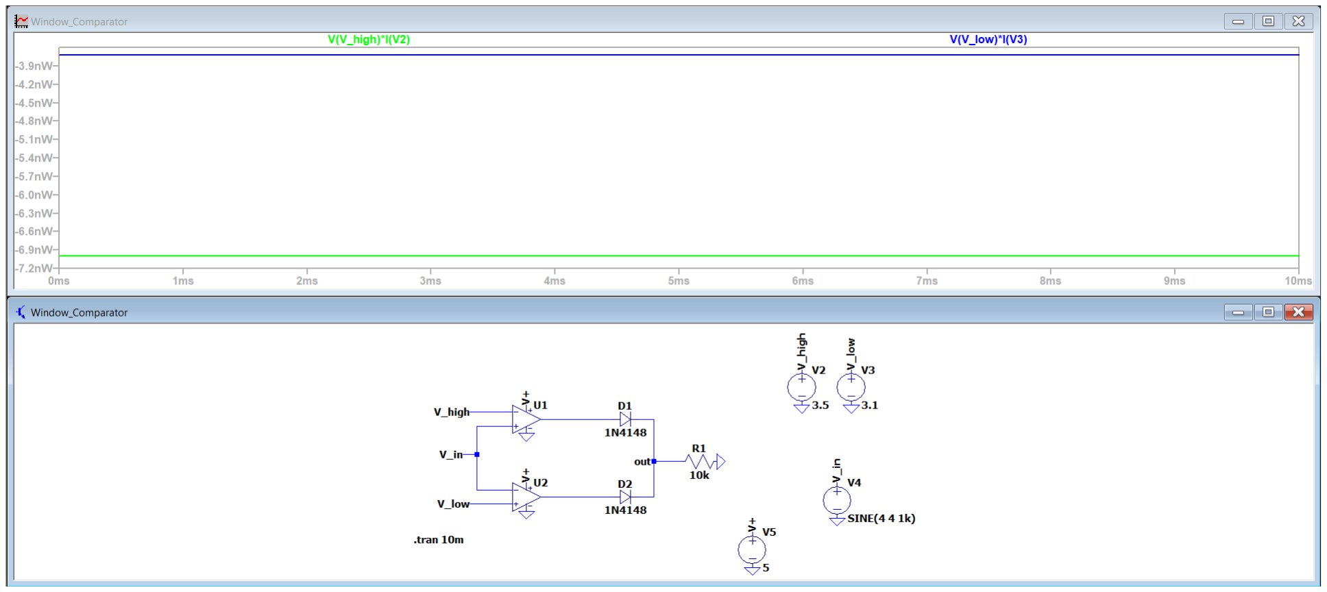
[picture p37: figure]

Fig. 34: Power consumed by reference voltages (in the order nanoWatts)

VIII. FULL INTEGRATED CIRCUIT
Fig. 36 shows the complete hardware implementation of the proposed system. The design follows a modular architecture, where each stage performs a specific function in the overall energy harvesting and regulation process.
The system consists of the following stages implemented in the same order:
- Piezoelectric sensors Array
- Rectifier
- Buffer
- Buck Converter with Controller
- Window Comparator

The figure below shows the complete block diagram of the implementation.

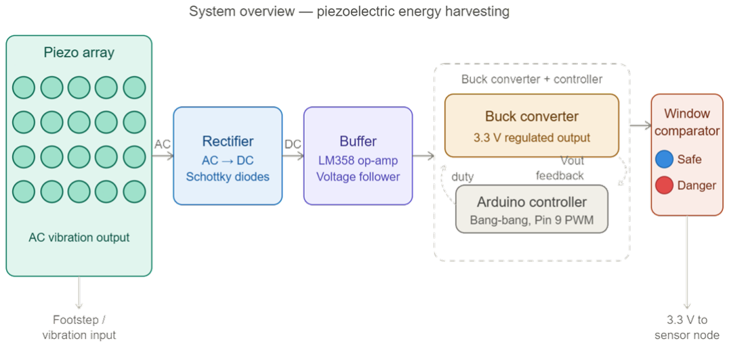
[picture p38: figure]

Fig. 35: Block Diagram of the Circuit

The system begins with the piezoelectric array, which converts mechanical energy into an AC electrical signal. This is followed by an AC–DC rectification stage that converts the generated signal into a usable DC voltage. Since the piezoelectric source exhibits high output impedance, an op-amp based buffer (unity-gain voltage follower) is introduced to provide impedance matching and prevent loading effects.

The buffered voltage is then fed into a buck converter stage, which steps down the varying DC input (typically in the range of 0–10 V) to a regulated 3.3 V output. This stage is controlled using a feedback-based controller implemented using Arduino microcontroller, ensuring stable output despite fluctuations in the input.

Finally, a window comparator is employed to monitor the regulated output voltage and determine whether it lies within a predefined safe operating range (3.1 V to 3.5 V). The output of this stage is used for visual indication of system status.

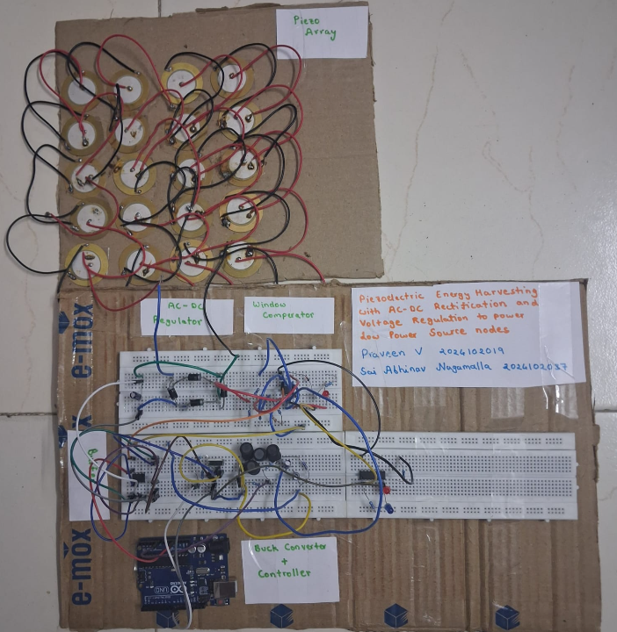
[picture p39: figure]

Fig. 36: Full hardware implementation of the piezoelectric energy harvesting system

Demonstration videos
The working of the full circuit is demonstrated through the videos titled Final which can be accessed here. (https://drive.google.com/drive/folders/1y0cQnUVNwf2e0C1tP7GsdZZJ_Ef59SJM?usp=drive_link)

IX. NOVELTY
The proposed system incorporates two key novelties that distinguish it from conventional piezoelectric energy harvesting implementations.
A. Efficient Voltage Regulation via Buck Converter
Voltage regulation is a critical requirement in any energy harvesting pipeline, as the harvested voltage must be conditioned to a stable, usable level before powering a load. Conventional regulation approaches, such as linear voltage regulator ICs (e.g., LM7805, LM317) or op-amp based regulators, operate by dissipating the excess input voltage as heat. This linear dissipation leads to significant power loss, which is particularly detrimental in a self-powered system where available energy is inherently limited.
In the proposed design, a PWM-controlled buck converter is employed in place of a linear regulator. The buck converter operates as a switching regulator, transferring energy in discrete pulses rather than continuously dissipating the voltage difference. This results in a theoretical switching efficiency of nearly 90%, compared to 40–60% typically achieved by linear regulators under similar conditions. Furthermore, the minimal heat dissipation characteristic of the buck converter makes it particularly well-suited for compact, self-powered embedded systems where thermal management is a constraint.
The converter is controlled by an Arduino Uno microcontroller implementing a bang-bang control algorithm. Timer1 is configured to generate a 50 kHz PWM signal on Pin 9, with the duty cycle dynamically adjusted based on feedback from a resistive voltage divider at the output. A 16-sample ADC averaging routine is employed to suppress noise in the feedback path, and a software undervoltage lockout mechanism prevents erroneous regulation when the input falls below a minimum threshold of 1.0 V.
B. Op-Amp Based Window Comparator for Safety Indication

A second novelty of the proposed system is the integration of an op-amp based window comparator at the regulated output stage. Unlike a simple threshold comparator that detects only over-voltage or under-voltage conditions independently, a window comparator simultaneously defines both an upper and a lower voltage boundary, flagging the output as valid only when it lies within the prescribed window.
In this implementation, the window comparator continuously monitors the 3.3 V regulated output and provides real-time visual indication of the operating state:
- Blue LED — illuminates when the output voltage lies within the safe operating range, confirming correct regulation
- Red LED — illuminates when the output voltage falls outside the defined window, indicating an under-voltage or over-voltage fault condition
This safety indication mechanism adds a layer of observability to the system that is absent in most energy harvesting prototypes, enabling immediate identification of fault conditions without requiring external measurement instrumentation. It is particularly relevant in unattended sensor node deployments where real-time monitoring of power supply integrity is essential.
X. ANALYSIS AND LIMITATIONS
A. Performance Analysis

The system successfully demonstrates energy harvesting, rectification, buffering, and regulated output generation. The output voltage is maintained at approximately 3.3 V with a deviation of ±1%, indicating satisfactory performance under dynamic input conditions. The system delivers power on the order of hundreds of milliwatts under peak excitation conditions, which is sufficient for powering low-power sensor nodes.
The harvested output power is inherently dependent on the amplitude and frequency of mechanical excitation applied to the piezoelectric array. Due to the intermittent and low-energy nature of such inputs (e.g., footsteps), the instantaneous power output varies significantly. As a result, the system is best suited for low-power applications with intermittent duty cycles. Typical low-power sensor nodes require power in the range of a few milliwatts, depending on the sensing, processing, and communication requirements. This is sufficient for duty-cycled operation of ultra-low-power sensors and wireless transmission modules.

B. Sources of Error and Non-Idealities
Several non-ideal factors affect the performance of the system:
- Component Tolerances: Resistors used in voltage dividers and reference generation introduce errors due to tolerance (typically ±1% or ±5%), affecting threshold accuracy and sensed voltage.
- Diode Voltage Drop: The rectifier stage introduces a forward voltage drop (approximately 0.2–0.3 V per diode), reducing the effective harvested voltage, especially at low input levels.
- Piezoelectric Source Impedance: The piezoelectric element behaves as a high-impedance source with capacitive characteristics. Any mismatch or loading significantly reduces the extractable power.
- Switching Losses: The buck converter introduces switching and conduction losses, reducing overall efficiency, particularly at low power levels.
- Measurement Limitations: ADC quantization and noise in the Arduino introduce small errors in voltage sensing and control decisions.
C. Design Limitations
- Buck Controller: Commercially available solutions often exist in the form of evaluation boards, which are optimized for performance but are typically expensive. Alternatively, a custom PCB implementation using a suitable controller IC provides a cost-effective and compact solution, allowing full customization of the control circuitry. However, designing and fabricating such hardware was beyond the scope of this course project.
- Use of Arduino: The Arduino-based controller is not power-efficient and requires an external supply, making it unsuitable for fully autonomous deployment. It is used here solely for validation of the control strategy.
- Lack of Cold-Start Optimization: The current implementation does not include a dedicated cold-start mechanism, which is critical for real-world energy harvesting systems.
- Diode-Based Rectification: The use of standard diodes limits efficiency at low voltages due to forward voltage drops.
- Absence of Energy Storage: The system does not incorporate a storage element (e.g., supercapacitor or rechargeable battery), limiting its ability to supply continuous power during low or no excitation.
D. Actual Deployment Pitfalls
While the control algorithm is validated using a microcontroller, implementing the same control strategy in a dedicated hardware IC or custom PCB presents several challenges:
- Designing stable feedback compensation networks for analog controllers requires careful tuning and analysis of system dynamics.
- Integrating control logic (e.g., hysteretic or PID-based control) into hardware requires additional circuitry such as comparators, ramp generators, and compensation networks.
- Ensuring low quiescent current operation is critical in energy harvesting systems, which is non-trivial in discrete implementations.
- Commercial evaluation boards that provide such functionality are often expensive, while custom PCB design requires expertise and fabrication resources beyond the scope of this project.
E. Suggestions for Improvement
- Replace diode rectification with synchronous rectification to improve efficiency.
- A buck–boost converter can be employed instead of a simple buck converter to regulate both higher and lower input voltages to a stable 3.3 V output. However, implementing a stable control scheme for a buck–boost topology is more complex due to its non-linear dynamics and wider operating range. Hence, a buck converter was chosen in this work for simplicity and ease of implementation within the project scope.
- Incorporate energy storage elements (supercapacitors or thin-film batteries) to enable continuous operation.
- Implement maximum power point tracking (MPPT) techniques to maximize energy extraction from the piezoelectric source.
- Optimize the mechanical coupling of the piezoelectric element to improve energy conversion efficiency.

XI. CHALLENGES FACED
The development of the system involved several practical and conceptual challenges:
- Understanding the buck converter and controller: Gaining a clear understanding of the working principles of the buck converter and its control mechanism required significant effort, particularly in relating theoretical concepts to practical implementation.
- Soldering complexity: The hardware implementation required soldering a 4 × 5 array of piezoelectric sensors, which was time-consuming and required precision to ensure proper connections and reliable performance since the piezo sensors were too sensitive to high temperatures used for soldering.
- Low and intermittent power generation: The electrical output from the piezoelectric sensors is inherently low and highly dependent on mechanical excitation. This made it challenging to obtain a stable and sufficient input for further processing stages.
- Voltage loss in rectification: The AC–DC conversion stage introduces voltage drops due to the forward voltage of diodes, significantly reducing the effective usable output, especially at low input levels.
- Time constraints: The required components were requested at the outset of the project. However, delays in their procurement significantly reduced the available time. This directly limited the scope for iterative design, thorough testing, and optimization. Consequently, the implementation was constrained to a design with simple novelty, while more advanced features and refinements could not be fully realized within the given timeframe.
- Limited reference material: The availability of relevant and directly applicable literature for piezoelectric energy harvesting systems with integrated regulation and control was limited. This necessitated independent design decisions and increased the effort required for validation and troubleshooting.

XII. FURTHER/ONGOING RESEARCH

Recent research in piezoelectric energy harvesting is rapidly advancing, particularly in countries like Japan and the United States, with a focus on improving efficiency, scalability, and real-world applications.
One notable development is the use of piezoelectric materials in public infrastructure. Japan has experimented with embedding piezoelectric tiles in high-footfall areas such as railway stations, where mechanical energy from footsteps is converted into electrical energy. This demonstrates the potential of integrating energy harvesting into smart city environments (Watch demo). (https://www.youtube.com/watch?v=F4TT_q4yB4Q)
Another important area of research is vibration-based energy harvesting. Modern studies focus on extracting energy from low-frequency ambient vibrations (0–100 Hz), which are commonly found in real-world environments such as vehicles, buildings, and industrial systems. These systems are particularly useful for powering small, wireless sensors (View paper). (https://pubs.aip.org/aip/apr/article/1/4/041301/123585/Energy-harvesting-from-low-frequency-applications)
Overall, current project in hand aims to overcome key challenges such as low power output and efficiency limitations, with the ultimate goal of enabling battery-free IoT devices and sustainable energy solutions.

XIII. CONCLUSION

In this project, a piezoelectric energy harvesting system was successfully designed and implemented to generate electrical power from ambient mechanical vibrations. By utilizing an array of piezoelectric sensors, the inherently low and irregular output was improved in terms of both voltage and current. The generated AC signal was effectively converted into a usable DC output through a full-wave rectifier, followed by filtering to reduce ripple.
A buck converter was employed to regulate the output voltage to a stable 3.3 V, ensuring a supply suitable for low-power electronic applications. The control algorithm, implemented on an Arduino Uno, employs a hysteretic bang-bang strategy with ADC-based voltage feedback, achieving a regulation deviation of < 1%. A window comparator was integrated at the output stage to provide real-time visual safety indication, illuminating a blue LED when the output lies within the safe operating range and a red LED upon detection of an under-voltage or over-voltage fault condition.
Although the harvested power is relatively small, the results demonstrate the feasibility of piezoelectric energy harvesting as a sustainable alternative to conventional power sources for low-power devices. The system highlights the potential for integration into self-powered IoT applications, wearable electronics, and environments where battery replacement is impractical.

XIV. ACKNOWLEDGMENT
We would like to express my sincere gratitude to our instructors, Dr. Priyesh Shukla and Dr. Arti for proposing this project.
We also extend our thanks to our teaching assistants, Pranav and Ritama, for their support and assistance. Special thanks to Akshat for providing timely resources that greatly helped in completing this project.
Working on this project has been a valuable learning experience.

REFERENCES

[1] Youtube video of DC-DC Buck Converter Design by CAN education Available: here (https://youtu.be/fE1lxyE7ILI)
[2] Youtube video of DC-DC Buck Controller Design by CAN education Available: here (https://youtu.be/p5q5jMvsjto?si=1d5QAX8tF1hQb4Y4)
[3] Paper on piezoelectric Energy Harvester by Instructables; Available here (https://drive.google.com/drive/folders/1y0cQnUVNwf2e0C1tP7GsdZZJ_Ef59SJM?usp=drive_link) (named Piezoelectric Energy Harvester).
[4] Paper on piezo electric harvesting by Politehnica University Timisoara, 300006 Timisoara, Romania; Available here (https://drive.google.com/drive/folders/1y0cQnUVNwf2e0C1tP7GsdZZJ_Ef59SJM?usp=drive_link) (named sensors).
