NSA201006/Piezoelectric-Energy-Harvester/Schematics/AC-DC Regulator.asc

C1: cap; 50µ
C2: cap; 171.4n
D1: diode; 1N5819
D2: diode; 1N5819
D3: diode; 1N5819
D4: diode; 1N5819
Load: res; 50k
R2: res; 1.55Meg
V1: voltage; SINE(0 50 1k)
Named nets: 0, out
.tran 10m
