NSA201006/Piezoelectric-Energy-Harvester/Schematics/Buck_Converter.asc

C2: cap; 5µ
D1: diode; 1N5819
L1: ind; 890µ
Load: res; 3.3
U1: IRZ
V1: voltage; PULSE(0 3.3 0 0 0 6.7u 20u)
V2: voltage; 10
Named nets: out, 0
.tran 50m
.include IRFZ44N.txt
