NSA201006/Piezoelectric-Energy-Harvester/Schematics/FINAL.asc

C1: cap; 5µ
C2: cap; 500µ
C3: cap; 171.4n
D1: diode; 1N5819
D2: diode; 1N5819
D3: diode; 1N5819
D4: diode; 1N5819
D5: diode; 1N5819
L1: ind; 890µ
Load1: res; 3.3
R1: res; 1.55Meg
R2: res; 1Meg
U1: IRZ
V2: voltage; PULSE(0 3.3 0 0 0 7.6u 20u)
V3: voltage; SINE(0 10 1k)
Named nets: out, 0
.tran 50m
.include IRFZ44N.txt
