NSA201006/Piezoelectric-Energy-Harvester/Schematics/Window_Comparator.asc

D1: diode; 1N4148
D2: diode; 1N4148
R1: res; 10k
U1: UniversalOpAmp2
U2: UniversalOpAmp2
V2: voltage; 3.5
V3: voltage; 3.1
V4: voltage; SINE(4 4 1k)
V5: voltage; 5
Named nets: V_in, 0, V_high, V_low, V+
.tran 10m
.dc V4 0 5 0.01
